chickenfried42/Lobber/BOM.csv

Name | Qty | Price/Unit ($) | Link
Esp32 | 1 | 5.21 | https://www.aliexpress.us/item/3256808584827377.html?curPageLogUid=aZhCseKckxbb
Joysticks | 2 | 1.19 | https://www.aliexpress.us/item/3256808897847272.html
Tactile Switches | 4 | 2.57 | https://www.aliexpress.us/item/3256804784951471.html?curPageLogUid=WmdAzJaw5dfP
MPU6050 breakout | 1 | 2.71 | https://www.aliexpress.us/item/3256807462344600.html?curPageLogUid=mx2pONRM8Hyh
IR Receiver 38khz | 1 | 1.78 | https://www.aliexpress.us/item/3256807990185007.html?scm_id=1007.40050.354490.0&scm-url=1007.40050.354490.0
SSD1306 | 1 | 4.17 | https://www.aliexpress.us/item/3256805954920554.html?curPageLogUid=gnXG8jOLTMyR
NRF24L01 | 1 | 1.9 | https://www.aliexpress.us/item/3256808149584928.html?curPageLogUid=Tk2vdVdgps8I
Jumper Wires | <4269 |  | theyre really common
BT3x8 Self Tapping Screws | 4 | 1.07 | https://us.store.bambulab.com/products/bt3-socket-head-cap-self-tapping-screws-shcs-new?id=42382271611016
Total |  | 20.6
