chickenfried42/Lobber/CAD/button.stl

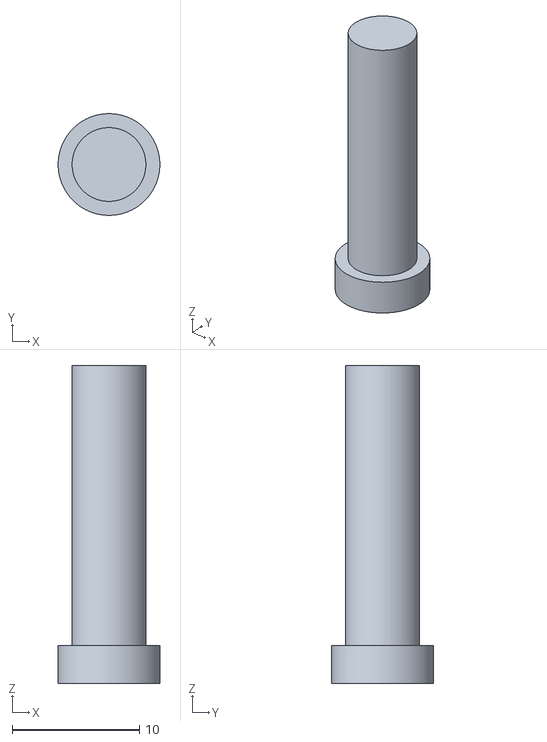
[picture p1: CAD file, 2026-07-04]
CAD/button.stl
8.00 x 7.99 x 25.0
