chickenfried42/Lobber/CAD/joystick mount.stl

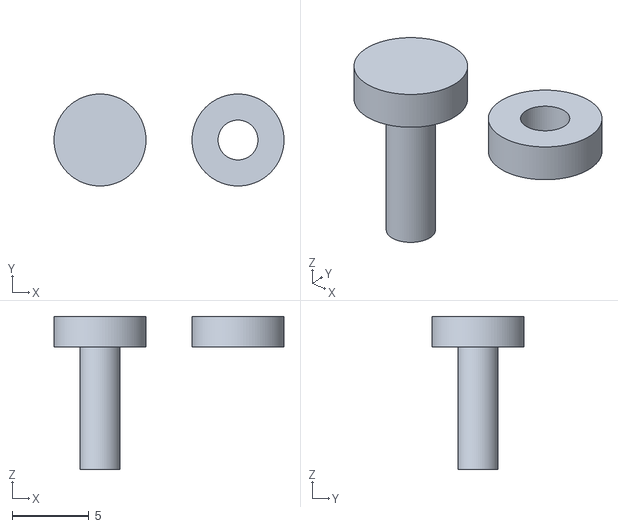
[picture p2: CAD file, 2026-07-04]
CAD/joystick mount.stl
15.0 x 6.00 x 10.0
