chickenfried42/Lobber/CAD/case cover.stl

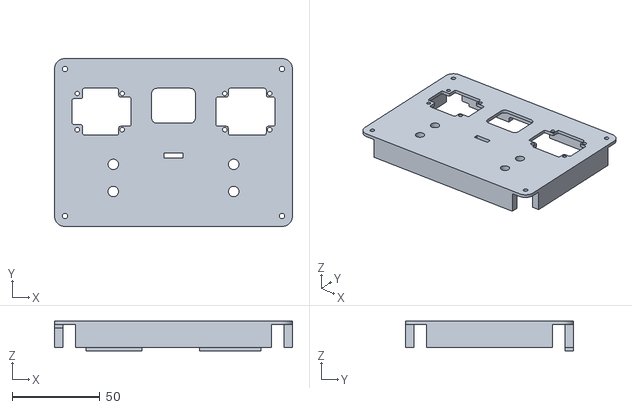
[picture p3: CAD file, 2026-07-04]
CAD/case cover.stl
136.0 x 96.0 x 17.0
