chickenfried42/Lobber/CAD/case base.stl

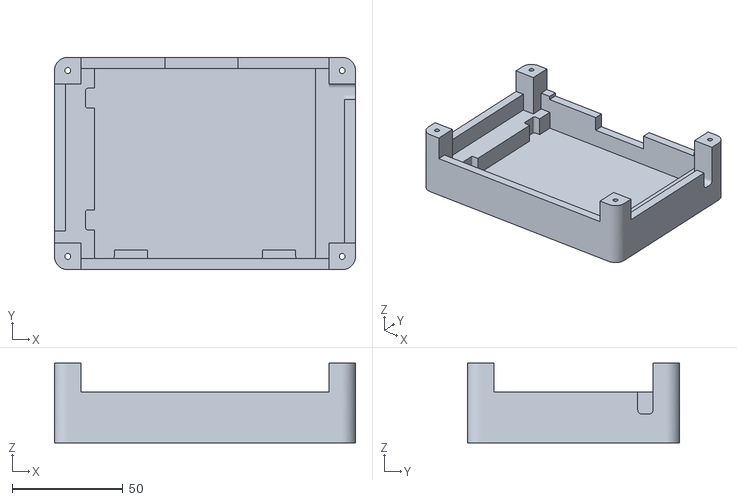
[picture p4: CAD file, 2026-07-04]
CAD/case base.stl
136.0 x 96.0 x 36.0
