chickenfried42/Lobber/(list of files, cad)

Other CAD files:
CAD/Source Files/button.f3d
CAD/Source Files/case base.f3d
CAD/Source Files/case cover.f3d
CAD/Source Files/joystick mount.f3d
